lixiang-moss/rover/Group 3.1 - Final Submission/Data Sheets/README.md

Components without data sheets:  
  
DC/DC Converter: <https://www.amazon.de/APKLVSR-DC-DC-Converter-Power-Supply/dp/B0D1K83XRZ>

MAX485 RS485 Transceiver-Modul: <https://www.amazon.de/DiGiYes-Transceiver-Modul-seriell-Instrumenten-Schnittstellenmodul-Entwicklungszubeh%C3%B6r/dp/B0BPSRF4J7>

Servo Motor Driver: <https://makerbase3d.com/product/makerbase-mks-servo57d/>
