lixiang-moss/rover/docs/STM32负责人USB通信与协议修改交接说明.md

# STM32 负责人 USB 通信与协议修改交接说明

> 接收人：STM32、驱动器和电机负责人
> 当前状态：Codex 已按接口合同提供一版 STM32 待审实现；STM32 负责人负责代码审查、实物参数确认、构建、烧录和硬件验收
> STM32 工程：`D:\rover\STM32`
> 文档日期：2026-07-03

## 1. 已冻结的信息

| 项目 | 最终要求 |
|---|---|
| STM32 型号 | STM32G474RE，当前工程目标器件 STM32G474RET6/STM32G474RETx |
| Pi 与 STM32 物理连接 | USB 数据线 |
| Pi 设备名 | udev 稳定别名 `/dev/mars-rover-stm32`，原始设备通常为 `/dev/ttyACM0` |
| Pi 与 STM32 协议 | `v=1` 紧凑 JSON + CRC32，协议内容不因 USB 改变 |
| 转向减速器 | NMRVS30，固定 30:1 |
| 转向减速比归属 | 只在 STM32 的转向单位换算中使用，ROS 2 不乘 30 |
| 转向 RS-485 | 当前工程 USART1，PC4/PC5，DE/RE 为 PB0 |
| 行走 RS-485 | 当前工程 USART3，PB10/PB11，DE/RE 为 PB1 |

## 2. 当前 STM32 工程状态

当前工程已经选择 STM32G474RE，型号不需要再改回 F446RE。

Pi 通信继续使用：

```text
PI_UART = LPUART1
RX = PC0
TX = PC1
```

2026-07-02 的 Pi 实测已经确认 USB 设备为 `STMicroelectronics STLINK-V3`，当前 LPUART1 固件能够通过该 VCP 接收命令并返回 ACK/STATUS。因此本次保留 ST-LINK VCP + LPUART1，不改成 MCU 原生 USB CDC。

本次代码状态：

| 项目 | 已实现内容 | STM32 负责人仍需确认 |
|---|---|---|
| Pi 接收 | LPUART1 中断 + 1024 字节环形缓冲区 + 换行切帧 | 用控制板原理图复核 PC0/PC1 与 ST-LINK VCP 的连接 |
| Pi 协议 | `v=1` 紧凑 W 帧、CRC32、严格字段与范围检查 | 用 Pi 固定测试向量做实板抓包 |
| Pi 回传 | 带 CRC32 的 ACK，约 5 Hz STATUS | 连续 20 Hz 压力测试 |
| 安全 | 0.5 秒 watchdog、急停/故障停止、默认真实输出锁定 | 实现硬件急停输入并做断线测试 |
| 驱动器 | MKS 与 BLD 的 Modbus 请求和响应校验 | 核对实物固件、地址、零位、方向和机械参数 |

完整文件级改动、默认锁定项和烧录顺序见 `docs/STM32固件v1协议与电机驱动改动说明_2026-07-03.md`。

## 3. 已实现内容与 STM32 负责人查验项

### 3.1 USB 接收与发送

当前方案已经确定为 ST-LINK V3 VCP，内部协议入口保持 LPUART1：

1. LPUART1 使用 115200、8N1、无流控。
2. 接收中断只把字节写入环形缓冲区，JSON 在主循环解析。
3. 正式协议通道不输出调试日志。
4. USB 拔出后由 0.5 秒命令 watchdog 停止全部输出。
5. STM32 负责人必须用控制板原理图复核 VCP 与 PC0/PC1 的板级连接。

### 3.2 Pi 协议已经改为当前 `v=1`

ROS 2 实际发送的是紧凑 W 帧：

```text
{"e":1,"m":3,"q":42,"s":0,"t":"W","v":1,"w":[[1,0.1,0.08,0.15,0.05],[0,0.0,0.0,0.15,0.05],[0,0.0,0.0,0.15,0.05],[0,0.0,0.0,0.15,0.05]]}*58782C06

```

当前固件已经：

1. 以 `\n` 结束一帧，最大完整帧 512 bytes。
2. 按 `*` 分离 JSON 和 8 位大写十六进制 CRC32。
3. CRC32 只覆盖星号前的原始 JSON 字节。
4. CRC 算法与 Python `zlib.crc32()` 一致。
5. 严格验证 `v,t,q,m,e,s,w`，拒绝额外字段、NaN、Inf、错误轮组数量和越界数值。
6. 四轮数组固定顺序为 front_left、front_right、rear_left、rear_right。

### 3.3 ACK 和 STATUS

每条有效 W 命令返回 ACK：

```text
{"fc":0,"ok":1,"q":42,"t":"A","v":1}*88B875B3
```

STM32 还需要约 5 Hz 主动返回 STATUS：

```text
{"es":0,"fc":0,"on":1,"q":42,"t":"S","to":0,"v":1}*F18BB4D1
```

要求：

- `on=1` 只能表示固件和当前测试所需设备已经就绪。
- `q` 是最近接受的命令序号。
- `es` 是软件或硬件急停。
- `to` 是 STM32 命令 watchdog 超时。
- `fc` 是当前最高优先级故障码。
- 不得在没有检查驱动器响应时固定返回 online=true。

### 3.4 Watchdog 和 USB 断线

超过 0.5 s 没有收到合法 W 帧时：

1. 停止全部行走输出。
2. 停止或安全终止正在执行的转向动作。
3. 禁止继续使用最后一条运动命令。
4. STATUS 设置 `to=1`。
5. USB 恢复后保持禁用，直到收到新的合法命令并满足安全条件。

### 3.5 转向减速比 30:1

当前代码在 `mwrs_config.h` 中固定：

```text
MWRS_STEERING_GEAR_RATIO = 30.0
```

`mwrs_units.c` 使用以下换算：

```text
执行器目标 = 机械零位 + 方向符号 × 车轮目标角 / (2π) × 30 × 执行器每圈坐标
```

STM32 负责人仍需确认：

- 30:1 只在 STM32 中应用一次。
- 每个轮组单独保存机械零位和方向符号。
- 使用 SERVO57D 支持的有符号多圈坐标。
- homing 完成前不得接受正式非零转向命令。
- 不能简单假设 200 步 × 16 细分就是 SERVO57D 的实际位置坐标。

### 3.6 两条 RS-485 总线

当前 G474 工程分配为：

| 用途 | UART | 引脚 | DE/RE |
|---|---|---|---|
| MKS SERVO57D | USART1 | PC4 TX / PC5 RX | PB0 |
| BLD-305S | USART3 | PB10 TX / PB11 RX | PB1 |

代码已经把 USART1 和 USART3 改为 115200、8N1，并实现 ID 1-4、Modbus 响应和 CRC16 校验。STM32 负责人需要：

1. 把实物 MKS 与 BLD 都配置成 115200、8N1 和各自的 ID 1-4。
2. 核对 MKS 实物固件与当前 V1.0.9 Modbus 寄存器是否兼容。
3. 核对 BLD-305S 的通信模式、极对数和故障读取结果。
4. 在单轮与四轮条件下验证请求超时不会阻塞 Pi 的 0.5 秒 watchdog。

## 4. STM32 负责人验收顺序

1. 不连接驱动器，只连接 Pi 和 STM32 USB。
2. Pi 能识别 `/dev/mars-rover-stm32`。
3. 固定 W 测试向量通过 CRC32 校验。
4. STM32 返回可被 ROS 2 解析的 ACK。
5. STM32 在没有 W 命令时仍约 5 Hz 返回 STATUS。
6. 暂停 W 超过 0.5 s，STATUS 返回 `to=1`。
7. 拔掉 USB，确认全部执行输出保持停止。
8. USB 恢复后保持禁用，不自动恢复旧命令。
9. 再分别连接 SERVO57D ID 1 和 BLD-305S ID 1。
10. 完成单轮 homing、小角度转向、低速正反转、停止和故障测试。

## 5. 交付给 ROS 2 负责人的内容

STM32 负责人需要提供：

- 最终选择的 USB 方案：ST-LINK VCP 或 MCU 原生 USB CDC。
- USB 对应的 MCU 外设、引脚和控制板接口。
- CubeIDE 工程和可烧录文件。
- 固定 W/A/S 抓包和 CRC32 结果。
- 20 Hz W、逐帧 ACK、约 5 Hz STATUS 的连续测试记录。
- USB 拔出、重新插入和 watchdog 停止测试记录。
- 转向 30:1 换算公式、每轮零位和方向符号。
- 两条 RS-485 的 UART 参数、ID、寄存器和故障读取结果。

本次代码由 Codex 按冻结接口实现，但真实硬件正确性仍由 STM32 负责人审核和验收。若审查后需要调整协议字段，应先更新双方接口合同并通知 ROS 2 负责人，不能只改单侧代码。
