lixiang-moss/rover/docs/STM32直连电机驱动硬件测试方案.md

# STM32 直接测试电机驱动器与电机硬件可用性方案

> 版本：2026-05-26  
> 面向读者：负责 STM32、驱动器接线、电机测试、电气安全的同学  
> 文档性质：硬件与底层固件测试方案，不是 ROS 2 方案，不要求编写 ROS 2 代码  
> 核心问题：是否可以不经过 Raspberry Pi / ROS 2，直接用 STM32 测试驱动器和电机是否可用？  

---

## 1. 结论

可以，而且应该这样做。

在接入 ROS 2 之前，负责 STM32 的同学完全可以、也应该直接用 STM32 测试电机驱动器和电机硬件是否可用。原因是：

- 这能把问题限定在“STM32、RS-485、驱动器、电机、电源、接线”这一层。
- 如果电机不转、方向反了、驱动器不应答、Modbus 帧错误、电源掉压，这些问题不应该先让 ROS 2 参与。
- ROS 2 侧只负责给出高层目标，例如转向角 `rad`、车轮线速度 `m/s`、enable、stop、estop。
- STM32 侧必须先证明自己能稳定控制一个转向电机和一个驱动电机，然后再扩展到四个轮组。

最推荐的验证路线是：

```text
电脑串口终端
  -> USB / UART
  -> STM32
-> USART1 + RS-485 收发器
  -> MKS SERVO57D 转向驱动器
  -> NEMA23 转向电机

电脑串口终端
  -> USB / UART
  -> STM32
-> USART3 + RS-485 收发器
  -> BLD-305S BLDC 驱动器
  -> 57BL04 BLDC 驱动电机
```

这个方案和 ROS 2 无关。ROS 2 只在后续阶段接入 STM32 的上层命令接口。

---

## 2. 已知硬件与前置事实

根据当前项目文档，系统硬件大致如下：

| 类别 | 型号 / 参数 | 用途 | 底层测试关注点 |
|---|---|---|---|
| STM32 控制器 | STM32G474RE，当前工程目标器件 STM32G474RET6 | 低层实时控制 | UART、GPIO、RS-485 方向控制、Modbus RTU |
| 转向电机 | NEMA 23，两相，1.8 度步距角 | 控制车轮转向角 | 方向、速度、零位、限位、是否丢步或报警 |
| 转向减速器 | NMRVS30，30:1 蜗轮蜗杆 | 转向减速增矩 | 机械自锁、速度较慢、线缆扭转风险 |
| 转向驱动器 | MKS SERVO57D | 控制 NEMA23 转向电机 | RS-485 / Modbus、ID、波特率、方向、报警读取 |
| 驱动电机 | 57BL04，三相 BLDC，约 69 W，3000 RPM | 车轮驱动 | 启停、方向、速度、霍尔线、相线、报警 |
| BLDC 驱动器 | BLD-305S，已由用户确认 | 控制 BLDC 驱动电机 | Modbus 寄存器、使能、速度设定、方向、实际速度 |
| 电机电源 | 24 V LiFePO4 电池或受限流电源 | 驱动器功率供电 | 急停、保险丝、限流、压降、线径 |
| RS-485 收发器 | MAX485 或同类模块 | STM32 UART 转 RS-485 | A/B 极性、DE/RE 控制、终端电阻、共地 |

上一届资料中提到的通信结构：

| 接口 | 用途 | 参考参数 |
|---|---|---|
| STM32 USB Virtual COM / UART1 | 电脑或 Pi 给 STM32 发高层测试命令 | 适合调试命令行 |
| USART1 + RS-485 收发器 | STM32 控制 MKS SERVO57D，ID 1-4 | 当前代码 PC4/PC5，通信格式按实物确认 |
| USART3 + RS-485 收发器 | STM32 控制 BLD-305S，ID 1-4 | 当前代码 PB10/PB11，BLD-305S 要求 115200 bps、8N1 |

上一届测试状态：

- 曾测试过一个 MKS SERVO57D。
- 旧资料中曾测试过一个 BLD-405S；当前实际型号已确认为 BLD-305S，需要按 BLD-305S 重新验证。
- 曾通过 STM32 把高层命令转换为 Modbus register write。
- 曾验证过 run/stop、speed、direction。
- 没有完成四轮完整集成。
- 没有完成多电机同步、负载下测试、连续反馈轮询。

因此，本次 STM32 测试不是从零开始，但必须重新验证硬件、接线、驱动器型号、通信参数和安全策略。

---

## 3. 本测试方案的边界

本方案要验证：

- STM32 能不能通过串口接收测试命令。
- STM32 能不能通过 RS-485 与驱动器通信。
- MKS SERVO57D 是否能控制转向电机转动、停止、反转。
- BLD-305S 是否能控制 BLDC 驱动电机启动、停止、反转、调速。
- 驱动器 ID、波特率、校验位、接线是否正确。
- 单个轮组的“转向 + 驱动”硬件链路是否可用。
- 四个轮组逐步接入后是否都能被单独寻址和停止。

本方案不验证：

- ROS 2 网络是否正常。
- `/cmd_vel` 是否正常。
- Raspberry Pi 是否能控制 STM32。
- RViz、URDF、joint states 是否正常。
- 四轮运动学是否正确。
- 整车落地运动是否安全可靠。

换句话说，STM32 直接测试的目标是回答：

> 这些驱动器和电机在底层是否能被 STM32 稳定、可控、安全地操作？

而不是回答：

> ROS 2 的控制系统是否已经完成？

---

## 4. 推荐测试架构

### 4.1 推荐的正式测试路径：STM32 + RS-485 + Modbus

这是最推荐的路径，因为它最接近最终系统架构。

```text
电脑
  串口终端，例如 Tera Term / PuTTY / minicom
  |
  | USB Virtual COM
  v
STM32
  |
| USART1 TX/RX + DE/RE GPIO
  v
MAX485
  |
  | RS-485 A/B
  v
MKS SERVO57D
  |
  v
NEMA23 转向电机

STM32
  |
| USART3 TX/RX + DE/RE GPIO
  v
MAX485
  |
  | RS-485 A/B
  v
BLD-305S
  |
  v
57BL04 BLDC 驱动电机
```

优点：

- 和最终项目的底层架构一致。
- 可以验证驱动器 ID、Modbus 帧、CRC、读写寄存器。
- 以后 Raspberry Pi / ROS 2 只需要向 STM32 发抽象目标，不需要直接碰驱动器寄存器。

缺点：

- 需要 STM32 同学正确实现 Modbus RTU。
- 需要明确每种驱动器的寄存器地址、波特率、校验位、ID。
- 如果驱动器没有应答，排查范围包括 UART、MAX485、A/B 线、DE/RE、CRC、寄存器、驱动器参数。

### 4.2 仅用于排查硬件的临时路径：离散信号 / 脉冲 / PWM

有些驱动器可能支持：

- `PUL / DIR / ENA` 控制步进驱动器。
- `PWM / DIR / EN` 控制 BLDC 驱动器。
- 模拟电压或外部电位器控制速度。

这类方式可以作为临时硬件排查手段。例如怀疑 Modbus 不通时，可以用简单信号确认“电机和驱动器本体是否能动”。

但是必须注意：

- 这不是推荐的最终项目控制路径。
- 不能因为临时 PWM 能让电机转，就跳过 RS-485 / Modbus 测试。
- ROS 2 方案中的 STM32 仍应优先通过 RS-485 / Modbus 控制驱动器。

建议定位：

| 路径 | 适合用途 | 是否推荐作为最终方案 |
|---|---|---|
| STM32 + RS-485 + Modbus | 正式底层验证 | 是 |
| USB-RS485 转接器 + PC 工具 | 独立验证驱动器参数和寄存器 | 是，作为辅助 |
| STM32 + PUL/DIR/ENA | 排查步进驱动器或电机本体 | 只作为临时测试 |
| STM32 + PWM/DIR/EN | 排查 BLDC 驱动器或电机本体 | 只作为临时测试 |

---

## 5. 测试前安全准备

### 5.1 机械安全

任何电机测试前必须满足：

- 轮子离地，或单独把电机从机械负载上拆下来测试。
- 转向机构周围没有手、线缆、工具。
- 转向电机只能小角度、低速测试，防止扭断线缆。
- BLDC 驱动电机首次测试不接车轮或让车轮悬空。
- 测试人员必须知道如何立即断电。

### 5.2 电气安全

必须准备：

- 物理急停按钮，最好能切断驱动器 24 V 电源。
- 保险丝或限流保护。
- 可调限流电源。首次测试优先使用限流电源，不建议一开始直接上电池。
- 万用表。
- 如果有条件，准备示波器或逻辑分析仪，用于看 UART/RS-485 波形。
- 明确的公共地连接。STM32、MAX485、驱动器控制侧必须有正确参考地。

首次测试建议：

| 项目 | 建议 |
|---|---|
| 24 V 电源 | 先用限流电源，电流限制设低 |
| 电机速度 | 从非常低的速度开始 |
| 转向角 | 从很小角度开始 |
| 测试时长 | 单次运行 1-3 秒，然后停止 |
| 负载 | 先空载，再轻负载，最后才接完整机构 |

### 5.3 上电顺序建议

推荐顺序：

1. STM32 只接 USB，确认固件能启动，串口能打印日志。
2. 接 MAX485 模块，但不接驱动器，确认 DE/RE GPIO 默认处于接收状态。
3. 接驱动器控制线，但不打开 24 V 功率电源，确认不会误动作。
4. 打开 24 V 限流电源，但不发送运行命令。
5. 发送“读状态”命令。
6. 发送“使能但速度为 0”命令。
7. 发送低速运行 1 秒。
8. 发送停止命令。
9. 断开 24 V，检查驱动器和电机温度、接线、异常声音。

---

## 6. STM32 测试固件建议

### 6.1 固件目标

STM32 测试固件不需要 ROS 2，也不需要复杂运动学。

它只需要提供一个清晰、可重复、可记录的底层测试接口。

建议 STM32 通过 USB Virtual COM 接收人类可读的文本命令，例如：

```text
help
scan stepper
scan bldc
mks ping 1
mks speed 1 cw 30 1000
mks stop 1
bldc ping 5
bldc speed 5 cw 200
bldc stop 5
wheel test front_left steer 0.1
wheel test front_left drive 0.03
stop all
estop
status
```

这些命令只是建议，不要求和 ROS 2 最终协议完全一样。它们的价值是让 STM32 同学能独立做硬件调试。

### 6.2 固件模块划分

建议 STM32 固件至少分成以下模块：

| 模块 | 职责 |
|---|---|
| `serial_console` | 通过 USB Virtual COM 接收测试命令，打印日志 |
| `rs485_bus` | 控制 UART + MAX485 DE/RE，发送和接收 RS-485 帧 |
| `modbus_rtu` | 生成 CRC16，封装读写寄存器，检查应答 |
| `mks_servo57d_driver` | 封装 MKS SERVO57D 的使能、速度、停止、读状态 |
| `bld_driver` | 封装 BLD-305S 的使能、速度、方向、停止、读状态 |
| `wheel_test` | 把一个轮组映射到一个转向驱动器 ID 和一个驱动驱动器 ID |
| `safety` | 超时停止、急停输入、错误锁定、全部停止 |

### 6.3 强制安全逻辑

STM32 测试固件必须有以下安全逻辑：

- 上电默认所有驱动器停止。
- 没有收到明确运行命令时，不允许电机转动。
- 每条运行命令必须有短超时时间，例如 500 ms 或 1000 ms。
- 超时后自动发送 stop。
- USB 串口断开或命令停止输入时，自动 stop all。
- 急停输入触发后，立即 stop all，并锁定运行命令。
- 只有收到明确 reset / clear fault 后才允许再次运行。
- 任意 Modbus 应答错误、CRC 错误、驱动器 fault，都应停止对应电机。

### 6.4 日志格式建议

STM32 每次操作都应该打印日志，便于定位问题。

建议日志包含：

```text
[BOOT] stm32 motor test firmware started
[BUS] usart1 steering bus, format confirmed from SERVO57D
[BUS] usart3 bldc bus 115200 8N1
[TX] mks id=1 write reg=0x00F6 ...
[RX] ok id=1 ...
[ERR] timeout bus=stepper id=1
[RUN] bldc id=5 dir=cw rpm=100
[STOP] all motors stopped reason=cmd_timeout
```

最重要的是：不要只让电机动起来，还要能知道为什么动、向谁发了什么、有没有收到应答。

---

## 7. RS-485 与 Modbus 测试重点

### 7.1 MAX485 接线检查

每条 RS-485 总线需要确认：

| 信号 | 检查内容 |
|---|---|
| STM32 TX | 接 MAX485 DI |
| STM32 RX | 接 MAX485 RO |
| DE | STM32 GPIO 控制，发送前拉高 |
| RE | 通常可与 DE 反相或直接和 DE 绑在一起，按模块设计确认 |
| A/B | 接驱动器 RS-485 A/B，若完全无应答可尝试对调 |
| GND | STM32 / MAX485 / 驱动器控制侧必须共地 |
| 终端电阻 | 总线长或多设备时考虑 120 Ω，短线单设备可先不加或按驱动器手册 |

### 7.2 DE/RE 时序

RS-485 半双工的常见错误是：STM32 刚发完最后一个字节就立刻切回接收，导致最后一位没发完整；或者一直保持发送模式，导致收不到应答。

推荐流程：

```text
DE = 1
UART transmit bytes
等待 UART TC 标志，确认最后一位发完
DE = 0
切回接收
等待驱动器应答
```

### 7.3 Modbus 参数必须统一

每种驱动器至少确认：

- Slave ID。
- 波特率。
- 数据位。
- 校验位。
- 停止位。
- 功能码。
- 寄存器地址。
- 字节序。
- CRC16 是否正确。

项目文档中曾出现：

- MKS SERVO57D：ID 1-4。
- BLDC 驱动器：ID 5-8。
- USART1 控制转向驱动器。
- USART3 控制 BLD-305S 驱动器。
- 有文档写 115200 bps，8-E-1。

但旧代码里也出现过 57600 bps、8-N-1 的注释。因此 STM32 同学必须以当前实际驱动器手册和驱动器当前配置为准，不能盲目相信旧代码。

---

## 8. 分步测试流程

### Step 0：只测试 STM32 本体

目标：

- STM32 能下载固件。
- USB 串口能输出日志。
- 命令解析能工作。
- 不接任何驱动器时不会卡死。

操作：

1. STM32 只接 USB。
2. 打开串口终端。
3. 发送 `help`。
4. 发送 `status`。
5. 发送 `stop all`。

验收：

- 串口能看到清晰命令列表。
- `stop all` 不报错。
- 固件不会因为没有驱动器而崩溃。

---

### Step 1：测试 RS-485 总线空载波形

目标：

- 确认 STM32 UART 到 MAX485 的发送方向和 DE/RE 控制正确。

操作：

1. 接 STM32 + MAX485。
2. 不接驱动器。
3. 用示波器或逻辑分析仪观察 TX、DE、A/B。
4. 发送一条 Modbus 测试帧。

验收：

- DE 在发送前变为发送态。
- UART 有字节输出。
- A/B 差分线上有波形。
- 发送结束后 DE 回到接收态。

如果没有示波器：

- 至少用 USB-RS485 转接器作为监听设备，确认能看到帧。

---

### Step 2：单独测试 MKS SERVO57D 转向驱动器

目标：

- STM32 能和一个 MKS SERVO57D 通信。
- 转向电机能低速转动、反转、停止。

接线：

```text
STM32 USART1
  -> MAX485
  -> MKS SERVO57D RS-485
  -> NEMA23 转向电机

24 V 电源
  -> MKS SERVO57D 功率输入
```

建议只接一个驱动器，ID 先用 `1`。

测试命令建议：

```text
mks ping 1
mks read_status 1
mks speed 1 cw 10 500
mks stop 1
mks speed 1 ccw 10 500
mks stop 1
```

参数含义建议：

| 参数 | 含义 |
|---|---|
| `1` | 驱动器 ID |
| `cw / ccw` | 方向 |
| `10` | 非常小的速度或 rpm，具体单位由固件内部定义 |
| `500` | 运行时间 ms，超时自动停止 |

验收：

- 驱动器能应答。
- 正转、反转方向可观察且可记录。
- 停止命令有效。
- 超时停止有效。
- 急停有效。
- 驱动器无 fault。
- 电机和驱动器不过热。

注意：

- 转向机构如果已经连到车体，必须防止无限旋转扭线。
- 首次测试不要追求角度闭环，只验证“能按命令转、能停、方向可控”。
- 如果 MKS SERVO57D 支持位置模式，后续再测试绝对/相对角度控制。

---

### Step 3：单独测试 BLDC 驱动器和 57BL04 驱动电机

目标：

- STM32 能和一个 BLD-305S 通信。
- BLDC 电机能启动、停止、反转、低速调速。

接线：

```text
STM32 USART3
  -> MAX485
  -> BLD-305S RS-485
  -> 57BL04 三相 BLDC 电机

24 V 电源
  -> BLDC 驱动器功率输入

BLDC 电机
  -> U/V/W 三相线
  -> Hall 传感器线，如果该驱动器需要
```

建议只接一个驱动器，ID 先用 `5`。

测试命令建议：

```text
bldc ping 5
bldc read_status 5
bldc speed 5 cw 50 500
bldc stop 5
bldc speed 5 ccw 50 500
bldc stop 5
bldc speed 5 cw 100 1000
bldc stop 5
```

验收：

- 驱动器能应答。
- 电机能平稳启动。
- 低速不剧烈抖动。
- 停止命令有效。
- 正反方向可记录。
- 电源电流在合理范围内。
- 驱动器无 fault。

特别注意：

- BLDC 三相线和 Hall 线如果接错，可能表现为抖动、不能启动、发热、报警。
- 不要频繁带电插拔 U/V/W 或 Hall 线。
- 旧资料或旧代码中的 BLD-405S 寄存器不能直接假设适用于 BLD-305S；必须以 BLD-305S 手册和实测为准。

---

### Step 4：建立驱动器 ID 与轮组映射

目标：

- 明确每个轮组对应哪个转向驱动器 ID 和哪个 BLDC 驱动器 ID。

推荐初始映射：

| 轮组 | 转向驱动器 ID | BLDC 驱动器 ID |
|---|---:|---:|
| `front_left` | 1 | 5 |
| `front_right` | 2 | 6 |
| `rear_left` | 3 | 7 |
| `rear_right` | 4 | 8 |

测试方式：

1. 只连接一个驱动器。
2. 发送对应 ID 的 ping。
3. 贴物理标签。
4. 记录到表格。
5. 再连接下一个。

验收：

- 每个 ID 只能对应一个实际驱动器。
- 不允许两个驱动器使用同一个 ID。
- 不允许文档 ID 和实际接线不一致。

---

### Step 5：测试一个完整轮组

目标：

- 验证一个轮组的转向电机和驱动电机可以协同工作。
- 建议从 `front_left` 开始。

接线：

```text
front_left:
  转向：MKS SERVO57D ID 1
  驱动：BLDC driver ID 5
```

测试命令建议：

```text
wheel select front_left
wheel steer front_left 0.10 1000
wheel steer front_left -0.10 1000
wheel steer front_left 0.00 1000
wheel drive front_left 0.02 1000
wheel stop front_left
wheel drive front_left -0.02 1000
wheel stop front_left
stop all
```

这里的 `0.10` 可以理解为目标转向角 rad，`0.02` 可以理解为车轮线速度 m/s。STM32 内部可以先临时换算成驱动器自己的单位。

验收：

- 转向能小角度正反动作。
- 驱动轮能低速正反动作。
- `wheel stop` 能停单个轮组。
- `stop all` 能停所有已连接驱动器。
- 转向和驱动不会互相干扰。
- 任何错误都能立即停止。

注意：

- 如果暂时没有转向绝对位置反馈，`wheel steer 0.10` 不能真正代表绝对角度，只能作为测试命令语义。
- 必须在日志中标注当前是“开环估计”还是“真实位置反馈”。

---

### Step 6：扩展到四个转向驱动器

目标：

- 四个 MKS SERVO57D 都能被独立寻址。
- 不要求同时高速转动，只验证通信和单独动作。

测试顺序：

1. 只接 ID 1，测试通过。
2. 接 ID 2，测试 ID 1 和 ID 2。
3. 接 ID 3，测试 ID 1/2/3。
4. 接 ID 4，测试 ID 1/2/3/4。

测试命令建议：

```text
mks ping 1
mks ping 2
mks ping 3
mks ping 4
mks speed 1 cw 10 300
mks speed 2 cw 10 300
mks speed 3 cw 10 300
mks speed 4 cw 10 300
stop all
```

验收：

- 每个 ID 都能应答。
- 发给 ID 1 的命令不会让 ID 2/3/4 动。
- 任意一个驱动器故障时，STM32 能报告具体 ID。
- `stop all` 能全部停止。

---

### Step 7：扩展到四个 BLDC 驱动器

目标：

- 四个 BLDC 驱动器都能被独立寻址。
- 每个驱动电机都能低速正反转和停止。

测试顺序：

1. 只接 ID 5，测试通过。
2. 接 ID 6，测试 ID 5 和 ID 6。
3. 接 ID 7，测试 ID 5/6/7。
4. 接 ID 8，测试 ID 5/6/7/8。

测试命令建议：

```text
bldc ping 5
bldc ping 6
bldc ping 7
bldc ping 8
bldc speed 5 cw 50 300
bldc speed 6 cw 50 300
bldc speed 7 cw 50 300
bldc speed 8 cw 50 300
stop all
```

验收：

- 每个 ID 都能应答。
- 每个电机方向记录清楚。
- 低速运行电流合理。
- 任意 BLDC fault 能被读出或至少被检测到。
- `stop all` 能全部停止。

---

### Step 8：四轮架空联动测试

目标：

- 在不依赖 ROS 2 的情况下，STM32 自己能执行简单四轮联动测试。

机器人必须架空，所有轮子离地。

建议 STM32 固件提供以下测试命令：

```text
vehicle stop
vehicle crab forward 0.02 1000
vehicle crab left 0.02 1000
vehicle spin cw 0.05 1000
vehicle stop
```

这些命令不需要做复杂 ROS 2 运动学，只需作为硬件联动测试：

- `crab forward`：四个转向尽量朝前，四个驱动轮同向低速。
- `crab left`：四个转向尽量朝左，四个驱动轮同向低速。
- `spin cw`：四个转向大致切向，四个驱动轮按旋转方向低速。

验收：

- 四个轮组不会突然高速运动。
- 四个转向方向大致正确。
- 四个驱动方向大致正确。
- `vehicle stop` 和物理急停能立即停止。
- 任意一个轮组 fault，整车测试命令必须停止。

注意：

- 这一步仍然不是 ROS 2 四轮运动学验收。
- 它只是证明 STM32 和硬件可以执行“四个轮组同时被控制”的底层能力。

---

## 9. 测试记录模板

建议 STM32 同学每次测试都填表，不要只口头说“能转”。

### 9.1 单驱动器测试记录

| 日期 | 测试人 | 设备 | ID | 波特率/格式 | 命令 | 结果 | 电流 | 温度 | 备注 |
|---|---|---|---:|---|---|---|---|---|---|
| | | MKS SERVO57D | 1 | | ping | | | | |
| | | MKS SERVO57D | 1 | | cw low speed | | | | |
| | | BLD-305S | 5 | | ping | | | | |
| | | BLD-305S | 5 | | cw low speed | | | | |

### 9.2 轮组映射记录

| 轮组 | 转向 ID | 转向方向是否正确 | 驱动 ID | 驱动方向是否正确 | 需要软件反向 |
|---|---:|---|---:|---|---|
| front_left | 1 | 待测 | 5 | 待测 | 待定 |
| front_right | 2 | 待测 | 6 | 待测 | 待定 |
| rear_left | 3 | 待测 | 7 | 待测 | 待定 |
| rear_right | 4 | 待测 | 8 | 待测 | 待定 |

### 9.3 故障记录

| 故障现象 | 可能原因 | 排查方式 | 结论 |
|---|---|---|---|
| 驱动器无应答 | A/B 接反、ID 错、波特率错、DE 未切换、CRC 错 | USB-RS485、示波器、单设备测试 | |
| 电机抖动不转 | BLDC 相线/Hall 错、速度太低、驱动器报警 | 查接线、读 fault、降低负载 | |
| 电机方向反 | 相线/方向位/机械安装方向 | 记录方向，在 STM32 参数中反向 | |
| 一发命令多个电机动 | ID 重复或总线接错 | 单独接入每个驱动器重新设 ID | |
| stop 无效 | 寄存器错误、enable 逻辑错误、固件未超时 | 独立测试 stop all 和急停 | |

---

## 10. 与 ROS 2 后续对接的接口建议

STM32 直接测试阶段可以用人类可读的命令。但为了后续和 ROS 2 对接，STM32 最终应支持一套稳定的上层协议。

建议 STM32 最终能接收：

```text
sequence_id
enabled
estop
mode
4 个轮组目标：
  name 或固定顺序
  wheel_enabled
  steering_angle_rad
  drive_velocity_mps
  steering_velocity_limit_radps
  drive_acceleration_limit_mps2
```

建议 STM32 最终能回传：

```text
ack_sequence_id
online
fault
fault_code
estop_active
每个轮组：
  online
  enabled
  steering_angle_rad
  drive_velocity_mps
  feedback_is_real
```

关键原则：

- ROS 2 不直接写 Modbus。
- STM32 负责把 `rad` 和 `m/s` 转换成具体驱动器命令。
- STM32 负责处理驱动器 ID、寄存器、CRC、超时、fault、急停。
- 如果 STM32 暂时没有真实反馈，必须明确告诉 ROS 2：当前反馈是目标回显或估计值，不是真实反馈。

---

## 11. STM32 同学需要确认的问题

### 11.1 板卡与接口

1. 实际控制器按当前工程确认为 STM32G474RE；仍需记录具体控制板型号、原理图版本和接口引出方式。
2. USB Virtual COM 是否可用？
3. USART1 和 USART3 是否已经按当前 STM32G474RE 工程分配给两条 RS-485 总线？
4. MAX485 的 DE/RE 控制 GPIO 分别是哪几个？
5. 是否有硬件急停输入接到 STM32？

### 11.2 驱动器参数

1. MKS SERVO57D 当前 ID 是多少？
2. MKS SERVO57D 当前波特率、校验位、停止位是多少？
3. MKS SERVO57D 当前是否启用 Modbus RTU？
4. BLD-305S 当前 ID 是多少？
5. BLD-305S 当前波特率、校验位、停止位是多少？
6. BLD-305S 的速度、方向、使能/停止、故障寄存器地址分别是什么？

### 11.3 电机与接线

1. 57BL04 的 Hall 线是否已正确连接？
2. BLDC U/V/W 相线是否有明确标记？
3. 转向电机和减速器是否已经装到轮组上？
4. 转向机构有没有机械限位？
5. 是否存在 slip ring？如果没有，允许转向角范围是多少？

### 11.4 安全策略

1. 急停是否切断 24 V 电机驱动器电源？
2. STM32 是否能读取急停状态？
3. STM32 通信超时时间设多少？
4. stop all 是否对所有驱动器都有效？
5. fault 后是否需要人工 reset？

---

## 12. 最终建议

STM32 负责人可以直接测试驱动器和电机硬件，而且这一步应该早于 ROS 2 真机联调。

推荐工作顺序是：

1. STM32 USB 串口命令行跑通。
2. RS-485 空载波形跑通。
3. 单个 MKS SERVO57D 跑通。
4. 单个 BLD-305S 跑通。
5. 一个完整轮组跑通。
6. 四个转向驱动器逐个跑通。
7. 四个 BLDC 驱动器逐个跑通。
8. 四轮架空低速联动跑通。
9. 再和 Raspberry Pi / ROS 2 对接。

这套流程的核心价值是：先证明“电机和驱动器可控”，再让 ROS 2 发送高层目标。否则一旦整车不动，很难判断问题是在 ROS 2、Pi 串口、STM32 协议、RS-485、驱动器、电源还是电机本体。
