lixiang-moss/rover/Group 3.1 - Final Submission/Requirements-List.pdf

# TU Berlin Requirements List

### for Modul | Mobile Working Robotic Systems

Order No.: SoSe-2025-3-1

Chair
Agro Mechatronics

Team Members: I. Zytoon,
N. Aschenbroich, J. Korn
Prof. Dr.-Ing.
C. Weltzien
Requirements | Specification – Data
No. | Date: | Origin | D/R (F/W) | | Minimum Fulfilment

STANDARD
Fulfilment

Ideal
Fulfilment

Unit
[mm]
General Requirements
G01 | 28.04.25 | C | D | Robust and safe design
G02 | 28.04.25 | C | D | Drivable omnidirectional robot platform
G03 | 28.04.25 | C | D | Drive-by-Wire control
G04 | 28.04.25 | C | D | Interface definition to/from navigation control
G05 | 28.04.25 | C | D | Fitting, robust & cost-efficient selection of electrical
components
G06 | 28.04.25 | C | D | Design for agricultural application, in remote
locations
G07 | 9.5.2025 | IZ | D | Use existing platform and motors (NEMA23
stepper, 57BLF03 BLDC)
G08 | 9.5.2025 | IZ | D | Compact, modular design for maintainability and
debug access
G09 | 28.04.25 | C | D | Completion of project until 16.07.25, submission of
documentation until 13.08.25

Specific Requirements (In Progress)
S01 | 28.04.25 | C | R | Remote control with MIT Inventor App via
Bluetooth/WIFI (Raspberry Pi needed)
S02 | 28.04.25 | JK | D | Multiple drive modes with flexible remote mode
switching
| | | | | Holo-
| | | | | nomic,
| | | | | spin-in-
| | | | | place

Holonomic,
spin-in-place,
Ackermann
S03 | 28.04.25 | JK | R | Fail-safe for loss of connection (e.g. ROS ping
messages)
S04 | 28.04.25 | C | R | Integration of hardware-level safety functionality
(Emergency Stop)
S05 | 28.04.25 | JK | R | ROS2 interface for future integration of advanced
autonomy (e.g. path planning, mapping)

Component Enclosure Requirements
C01 | 09.05.25 | JK | D | Robust enclosure for Raspberry Pi, STM32 board,
converters, and interfaces
| | | | | LWH:
| | | | | 170x198x
| | | | | 166 [mm]
C02 | 09.05.25 | JK, IZ | R | 3D printed from ABS, modular layout for additional
interface boards and sensors
C03 | 09.05.25 | JK | R | Screw cap, easy access for debugging and
maintenance
C04 | 09.05.25 | JK | R | Cable entries with sealed grommets
C05 | 09.05.25 | JK | D | Heat management | Passive
| | | | | (e.g. vent
| | | | | holes)

Active (One
or multiple
fans)
Process Requirements
P01 | 28.04.25 | C | D | Meet all deadlines and due dates
P02 | 28.04.25 | C | D | Keep to the house rules
P03 | 28.04.25 | C | D | Respectful and careful handling of facilities,
infrastructure, tools in student working room
P04 | 28.04.25 | JK | D | Extensive and timely documentation of work and
interface definition

Type of Requirements: D = Demands (F-Forderungen), R = Request (W-Wunsch, “nice-to-have”); C = Customer, JK = J. Korn, IZ = Iyhab Zytoon
Replaces version:2 | Version: | 3
From:28.04.25 | Date: | 09.05.2025
First version:
Responsible: | Page | 1 of 1
