lixiang-moss/rover/Group 3.1 - Final Submission/Parts-List-Final.pdf

Item No. | Component NameComponent Type | | Function/Role | Status | Quantity | Unit Price (€) Total Price (€) Source | | | Link | Order Date | Notes/Remarks
1 | Raspberry Pi 4 | Single-board computer | Central control unit running ROS and interfacing logic | Integrated | 1 | | | University | | | Will be provided by university
2 | STM32 F446RE | Microcontroller | Real-time motor control and Modbus communication | Purchased and | | | | | | | Total price incl. shipping cost
3 | DiGiYes MAX485 | Transceiver module | Transceiver for RS-485-communication | Purchased and integrated | 2 | | 18,77 € | Amazon (Offer for a 10 pack, unable to find | | | Other module possible if characteristics are the same. May be provided by Uni or ATB
4 | Jumper Wire | Wire | Electrical connections between components | Available | Various | | | Students | | | Will be provided by students
5 | | Component housing | | Manufactured by students, all .stp files in TUBCloud | 1 | | | Students | | | Preferably 3D printed from PETG, as the space requirements are predefined by the existing robot platform.
6 | APKLVSR | DC/DC Converter | Convert 24V current from battery to 5V for RPI and STM | Purchased and
7 | 57BL04 | Brushless DC Motor | Drive propulsion (Horizontal axis) Existing part | | 4 | | | | https://www.ebay.de/itm/225048395472 | | Provided/assembled by student in previous project
integrated | 1 | 20,50 € | 25,50 € | Reichelt | https://www.reichelt.de/de/de/shop/produkt/nucleo-64_arm_cortex_stm32_f446-serie-217196
lower quantity.) | https://www.amazon.de/DiGiYes-Transceiver-Modul-seriell-Instrumenten-Schnittstellenmodul-Entwicklungszubeh%C3%B6r/dp/B0BPSRF4J7
integrated | 1 | 9,59 € | 9,59 € | Amazon | https://www.amazon.de/APKLVSR-DC-DC-Converter-Power-Supply/dp/B0D1K83XRZ
8 | 23HE22-2804S | Servo Motor | Steering (Vertical axis) | Existing part | 4 | https://www.omc-stepperonline.com/de/nema-23-bipolar-1-8deg-1-26nm-178-4oz-in-2-8a-2-5v-57x57x56mm-4-draehte-23hs22-2804s
9 | BLD-305S | BLDC Motor Driver | Controls BLDC motor via
10 | MKS Servo57D | Servo Motor Driver | Controls servo motor via
Modbus | Existing part | 4 | https://www.omc-stepperonline.com/de/digitaler-buerstenloser-dc-motortreiber-12v-36-vdc-max-5-0a-120w-bld-405s
Modbus | Existing part | 4 | https://makerbase3d.com/product/makerbase-mks-servo57d/

53,86 €

Total Price:
