lixiang-moss/rover/Group 3.1 - Final Submission/Assembly Instruction for Component Housing.pdf

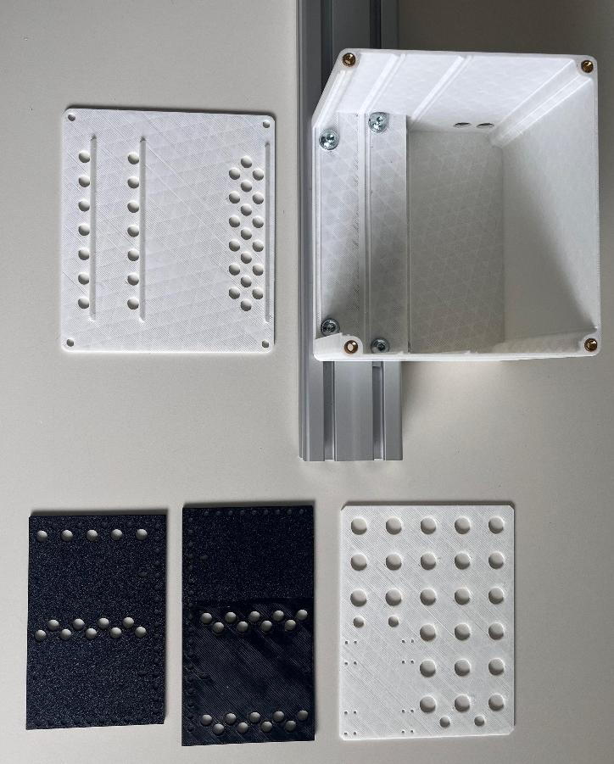
[picture p1: figure]
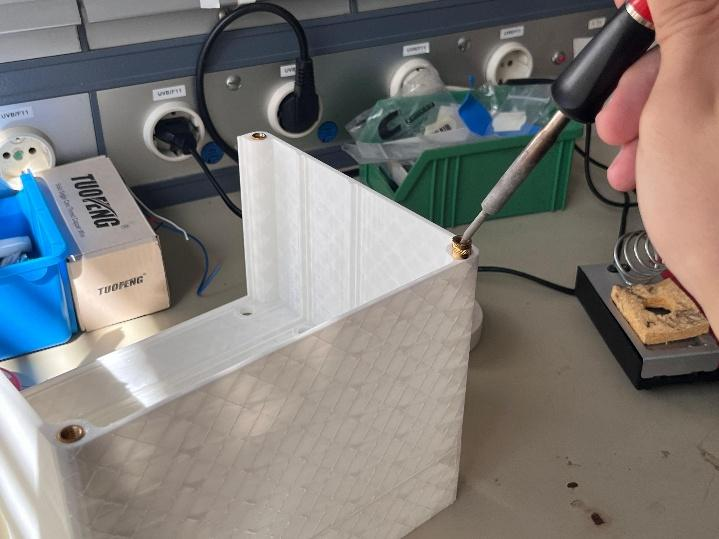
[picture p2: figure]

MARS – Group 3.1 – Assembly Instruction for Component Housing

Assembly Instruction for Component Housing
Step 1: Print/manufacture all parts.
Step 2: Melt the threaded inserts into the predesigned holes in the main body of the housing. This is best done with a soldering iron and a hammer.

Step 3: Insert T-slot nuts into the ITEM frame.

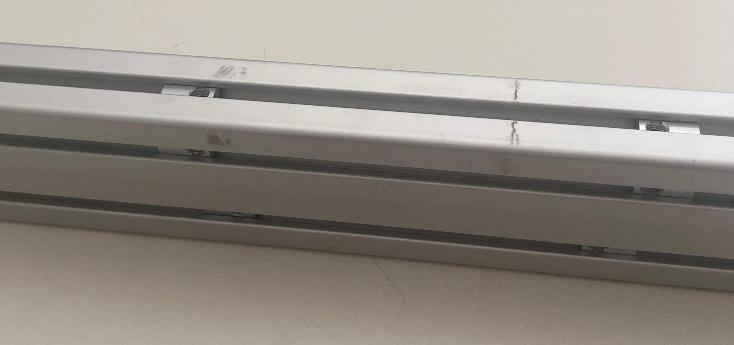
[picture p3: figure]

Step 4: Secure the main body to the frame with 6 M8 screws and washers.

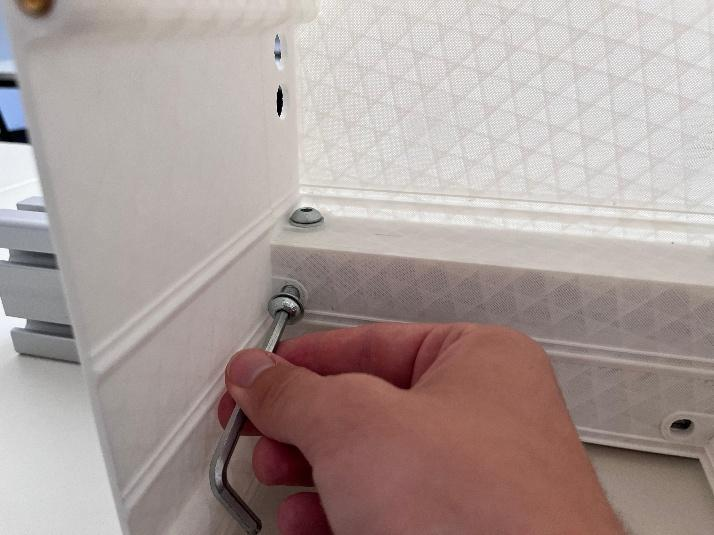
[picture p4: figure]

Step 5: Assemble the plates. Use the predesigned screw holes for the BLD-305S motor drivers and the Raspberry Pi.

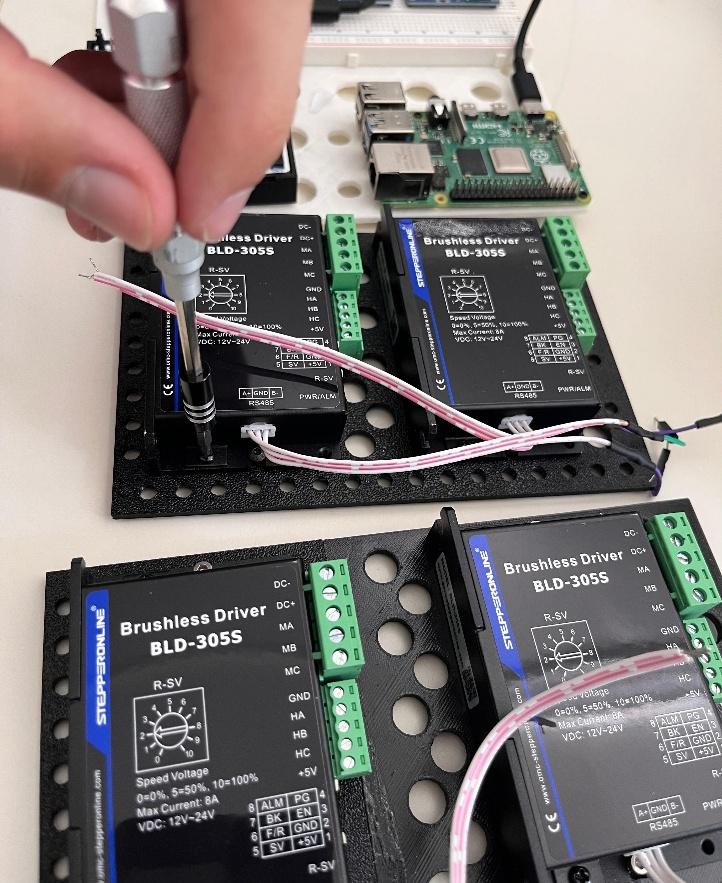
[picture p5: figure]

Step 6: Insert the plates on the respective level. Use the slots in the main body.

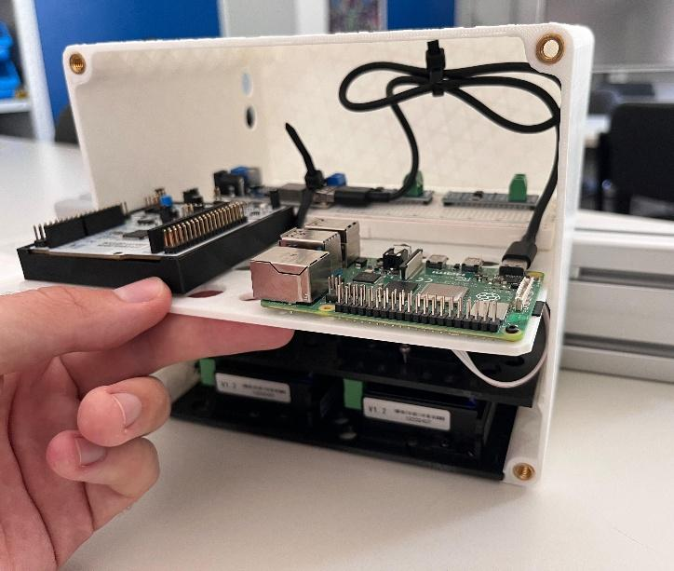
[picture p6: figure]

Step 7: Secure the lid with 4 M6 screws.

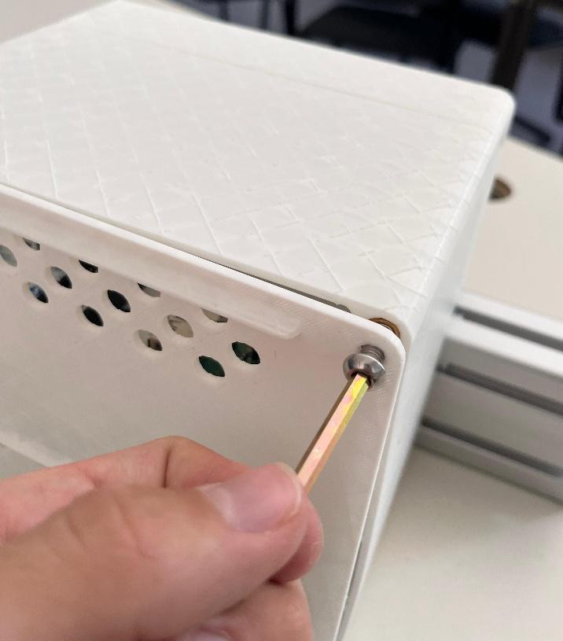
[picture p7: figure]

Step 8: (To be done) Once the robot is assembled, connect the cables to the battery, the servo motor drivers and the BLDC motors.
