lixiang-moss/rover/test_artifacts/2026-07-03_pc_pi_stm32/terminal_capture.html

MARS Rover Acceptance

Loading terminal evidence…
