lixiang-moss/rover/Group 3.1 - Final Submission/Component-Enclosure-Assembly-Drawing.pdf

A | B

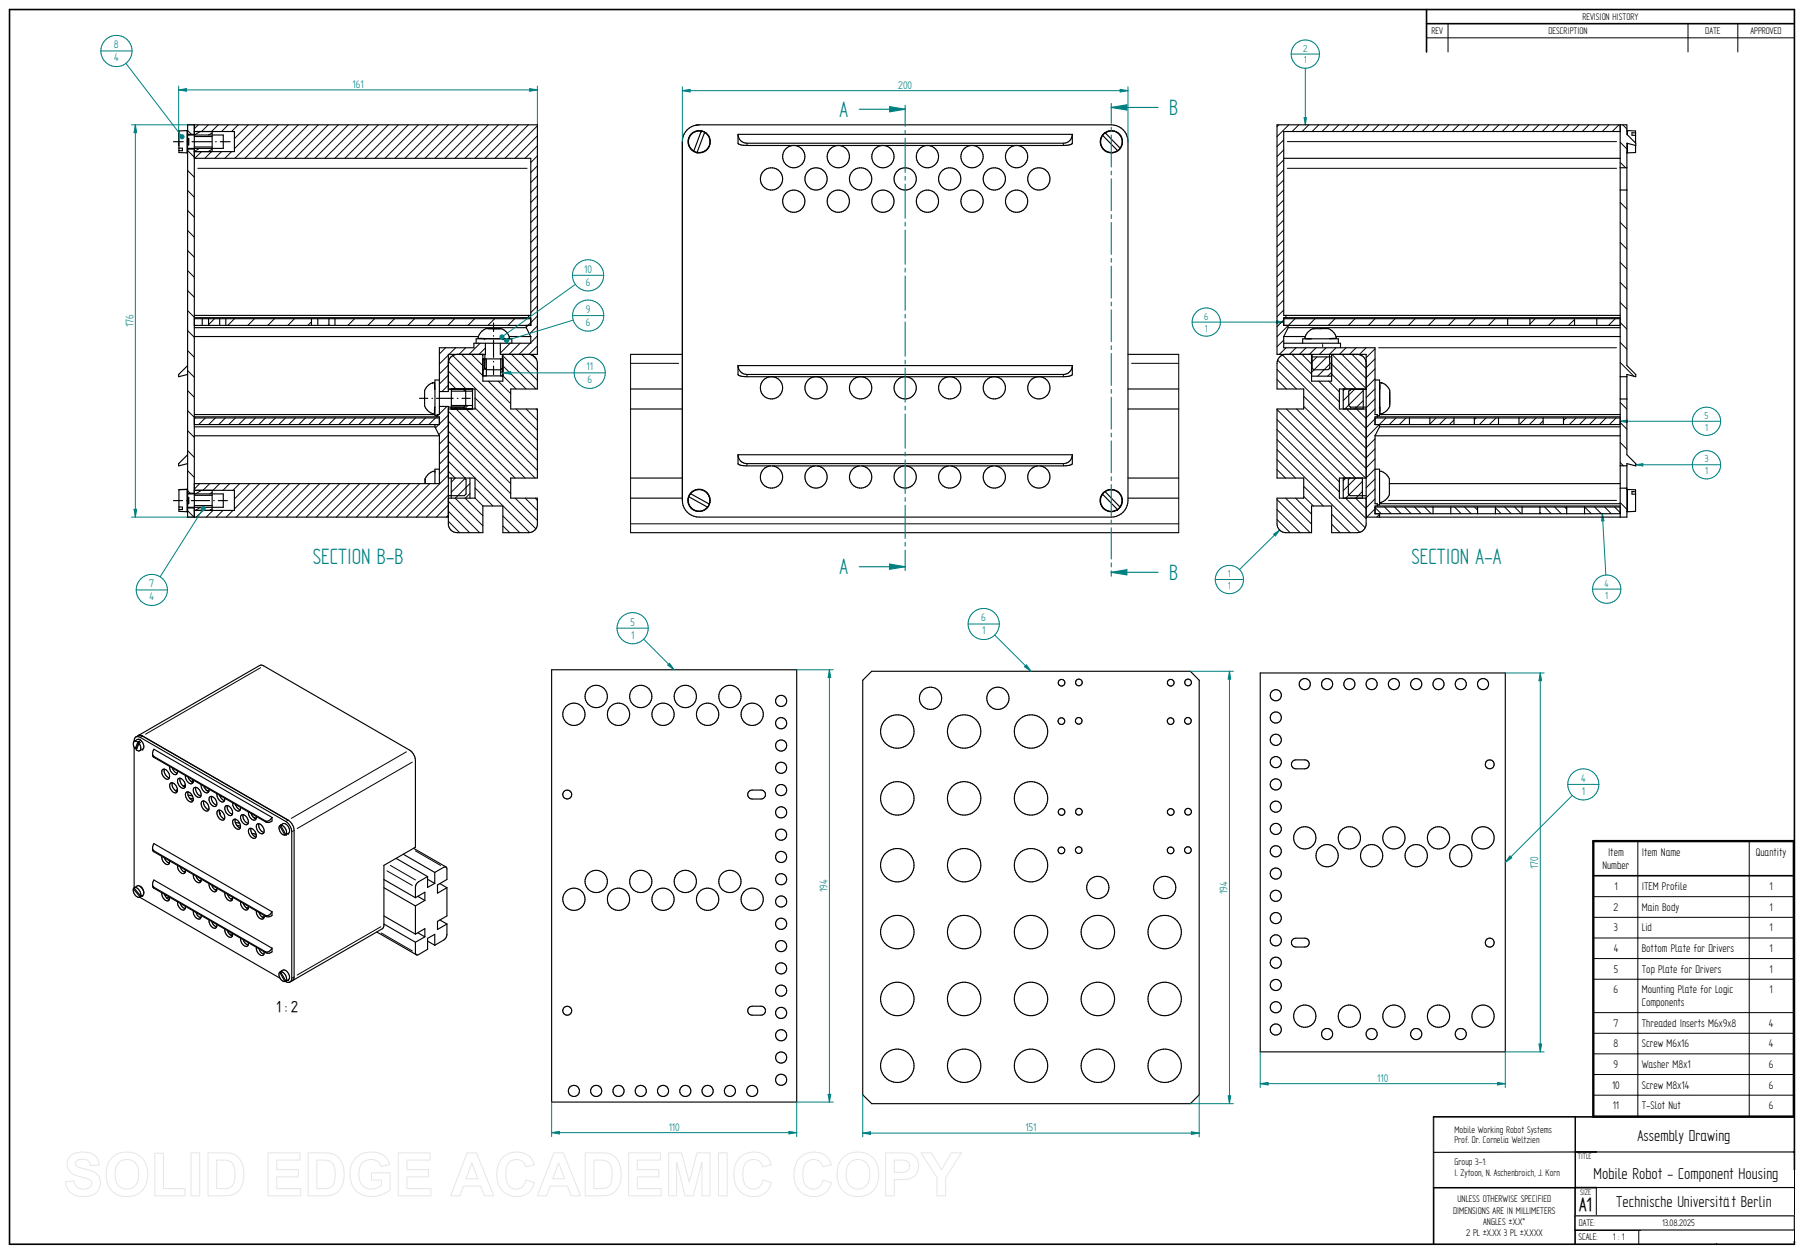
[picture p11: page 1]
SCALE:; WEIGHT:; SHEET 1 OF 1; Item Number; Item Name; Quantity; ITEM Profile; Main Body; Lid; Bottom Plate for Drivers; Top Plate for Drivers; Mounting Plate for Logic; Components; Threaded Inserts M6x9x8; Screw M6x16; Washer M8x1; Screw M8x14; T-Slot Nut; SECTION B-B; SECTION A-A; DATE:

REVISION HISTORY

REV | DESCRIPTION | DATE | APPROVED

Mobile Working Robot Systems | NAME | DATE 08/06/25 | Solid Edge Assembly Drawing
DRAWN Prof. Dr. Cornelia Weltzien | julia
CHECKED
Group 3-1: ENG APPR I. Zytoon, N. Aschenbroich, J. Korn
MGR APPR
UNLESS OTHERWISE SPECIFIED DIMENSIONS ARE IN MILLIMETERS ANGLES ±X.X° 2 PL ±X.XX 3 PL ±X.XXX | SIZE A1 | DWG NO Technische Universität Berlin | REV

TITLE
Mobile Robot - Component Housing

FILE NAME: Component_housing_new.dft
