lixiang-moss/rover/(list of files, drawings)

Other design files:
Group 3.1 - Final Submission/Wiring_MARS.fzz
