lixiang-moss/rover/STM32/STM32.ioc

Mcu.UserName=STM32G474RETx
PA13.Signal=SYS_JTMS-SWDIO
PA14.Signal=SYS_JTCK-SWCLK
PB0.GPIO_Label=RS485_DIR1
PB0.Signal=GPIO_Output
PB1.GPIO_Label=RS485_DIR2
PB1.Signal=GPIO_Output
PB10.Signal=USART3_TX
PB11.Signal=USART3_RX
PC0.Signal=LPUART1_RX
PC1.Signal=LPUART1_TX
PC4.Signal=USART1_TX
PC5.Signal=USART1_RX
