lixiang-moss/rover/STM32/Core/Inc/main.h

#define RS485_DIR1_Pin GPIO_PIN_0
#define RS485_DIR1_GPIO_Port GPIOB
#define RS485_DIR2_Pin GPIO_PIN_1
#define RS485_DIR2_GPIO_Port GPIOB
