lixiang-moss/rover/mars_rover_ws/src/mars_rover_bringup/config/single_wheel_test.yaml

# 单轮组真实测试配置。
# 该配置用于单轮硬件测试；仍从 STOP 启动，并只允许 STOP/RAW_WHEEL_TEST。
drive_mode_manager:
  ros__parameters:
    default_mode: STOP
    allowed_modes: [STOP, RAW_WHEEL_TEST]
    transition_hold_sec: 0.25

four_wheel_kinematics:
  ros__parameters:
    # 单轮测试默认只启用 front_left；后续可通过 active_test_wheel 参数切换到其他单轮组。
    active_test_wheel: front_left
    # 单轮测试最大转向角，单位 rad；比普通限幅更小，降低扭线和误动作风险。
    max_steering_angle: 0.35
    # 单轮测试最大驱动速度，单位 m/s。按 0.09 m 轮半径和 20:1 减速比，
    # 0.08 m/s 对应电机约 170 rpm，略高于 BLD-305S 手册给出的 150 rpm 调速下限。
    # 实车必须按实测轮径、实际减速比和驱动器表现重新确认。
    max_drive_velocity: 0.08
    # 单轮测试转向速度限制，单位 rad/s。
    steering_velocity_limit: 0.15
    # 单轮测试驱动加速度限制，单位 m/s^2。
    drive_acceleration_limit: 0.05

stm32_bridge:
  ros__parameters:
    # bridge 侧记录当前真实测试轮组，默认 front_left；该参数可切换到其他单轮组。
    active_test_wheel: front_left
    # 单轮测试策略允许 STOP；运动时只允许 RAW_WHEEL_TEST 中的一个轮组启用。
    hardware_output_mode: single_wheel
