lixiang-moss/rover/(commit log)

2026-05-23 Add ROS 2 first-stage rover workspace
    [mars_rover.urdf.xacro, robot_geometry.yaml]
2026-05-26 Support single-wheel and full-vehicle manual control
    [Antriebskomponenten.xlsx, Component_housing_assembly.stp, Driver_plate_bottom.obj, Driver_plate_top.stp, Housing_lid.stp, Housing_main_body.stp, Splash_protection_cover.stp, Wiring_MARS.fzz]
2026-05-26 Emphasize STM32 safety rules
2026-05-26 Remove final submission CAD models and code
    [Component_housing_assembly.stp, Driver_plate_bottom.obj, Driver_plate_top.stp, Housing_lid.stp, Housing_main_body.stp, Splash_protection_cover.stp, logic_plate.obj, stm_mount.obj]
2026-07-02 Sync rover docs and STM32 firmware project
2026-07-02 Add rover demonstration tools
    [demo_rover.urdf.xacro]
2026-07-02 Improve ROS 2 control safety and kinematics
2026-07-03 Implement STM32 v1 protocol and motor drivers
